Ethereal1679/Electronic-Design-Competition-2024E/README.md

# Electronic-Design-Competition-2024E
2024电子设计竞赛E题所有代码文件资料开源，方便大家学习交流！
## 代码结构
```
├─控制
│  ├─functions
│  └─tic_tac_toe
├─文件
└─视觉

```
气泵代码也一并给出。
硬件为OpenMv，星瞳的（其实是人家外国开源的。。。）和Arduino（具体型号等可看文档）

## 视频链接：
https://www.bilibili.com/video/BV1apijeUEMd/?spm_id_from=333.1387.homepage.video_card.click

## 欢迎
请留下github宝贵的Stars!!!
